joaomiguelvieira/Minotaur/pcb/minotaur_v2_0_BOM.csv

ID | Name | Designator | Footprint | Quantity | Manufacturer Part | Manufacturer | Supplier | Supplier Part | Price | Pins | JLCPCB Part Class | Contributor | Resistance (Ohms) | image
1 | 1234 | A1 | ARDUINO_NANO WITH MOUNTING HOLES | 1 | Arduino Nano |  |  |  |  | 30 |  | Der_Meister1979
2 | HNB09A05 | BUZZER | BUZ-TH_BD9.6-P5.00-D0.7-FD | 1 | HNB09A05 | HNDZ | LCSC | C96493 | 0.035 | 2
3 | 100nF | C1 | CAP-TH_L7.2-W2.5-P5.00-D0.5 | 1 | PE104J2A0501 | KYET(科雅) | LCSC | C390170 | 0.007 | 2 | Extended Part | LCSC
4 | 1nF | C2,C3 | CAP-TH_L7.2-W2.5-P5.00-D0.5 | 2 | PE102J2A0501 | KYET(科雅) | LCSC | C390167 | 0.008 | 2 | Extended Part | LCSC
5 | TC-1109-C-D | CLOSE,FUNC,OPEN,PROG,SELECT | KEY-TH_4P-L4.5-W4.5-P3.00-LS5.8 | 5 | TC-1109-C-D | XKB Enterprise | LCSC | C381026 | 0.005 | 4 |  | LCSC
6 | 39301240 | CN1 | CONN-TH_39301240 | 1 | 39301240 | MOLEX | LCSC | C492347 | 0.434 | 24 |  | LCSC
7 | 1N4148_C402212 | D1,D2,D3,D4,D5 | DO-35_BD2.0-L4.2-P8.20-D0.5-RD | 5 | 1N4148 | LGE | LCSC | C402212 | 0.001 | 2 |  | LCSC
8 | SS-12D02-VG4 | POWER | SW-TH_SS-12D02-VG4 | 1 | SS-12D02-VG4 | Rectangular Connectors - Contacts | LCSC | C136719 | 0.012 | 5 |  | LCSC
9 | BC547B | Q1,Q2,Q3,Q4,Q5 | TO-92-3_L4.9-W3.7-P1.27-L | 5 | BC547B | LGE | LCSC | C713613 | 0.004 | 3 | Extended Part | LCSC
10 | 51Ω | R1,R2,R3,R4,R5,R6,R7,R8,R9,R10 | RES-TH_BD2.3-L6.5-P10.50-D0.5 | 10 | CF1/4W-51Ω±5% T | CCO(千志电子) | LCSC | C120024 | 0.001 | 2 | Extended Part | LCSC | 51
11 | 100 | RB | RES-TH_BD2.5-L4.7-P8.70-D0.5 | 1 | CFS1/4CT26A101J | KOA Speer Elec | LCSC | C367443 | 0.036 | 2 |  | LCSC
12 | 1K | RC,RF,RO,RP | RES-TH_BD2.2-L6.5-P10.50-D0.9 | 4 | - | Chian Chia Elec | LCSC | C119870 | 0.001 | 2 |  | LCSC
13 | SRD-05VDC-SL-C | RLY1,RLY2,RLY3,RLY4,RLY5 | RELAY-TH_SRD-XXVDC-XL-C | 5 | SRD-05VDC-SL-C | SONGLE | LCSC | C35449 | 0.061 | 5 |  |  |  | //image.lceda.cn/szlcsc/C35449.jpg
14 | 1M | RS | RES-TH_BD2.3-L6.5-P10.50-D0.5 | 1 | - | Chian Chia Elec | LCSC | C120127 | 0.001 | 2 |  | LCSC
15 | 4N25 | U1,U2,U3,U4,U7 | DIP-6_L7.3-W6.5-P2.54-LS7.6-BL | 5 | 4N25 | EVERLIGHT | LCSC | C115480 | 0.025 | 6 |  | LCSC
16 | DB103-5.0-10P-GN-S | U5 | CONN-TH_10P-P5.00_DB103-5.0-10P-GN-S | 1 | DB103-5.0-10P-GN-S | DIBO | LCSC | C430588 | 0.115 | 10 |  | LCSC
17 | ACS712ELCTR-20A-T | U6,U8 | SOIC-8_L4.9-W3.9-P1.27-LS6.0-BL | 2 | ACS712ELCTR-20A-T | ALLEGRO(美国埃戈罗) | LCSC | C10681 | 0.354 | 8 | Extended Part
