joaomiguelvieira/Minotaur/doc/minotaur_v2_0_pcb_schematics.pdf

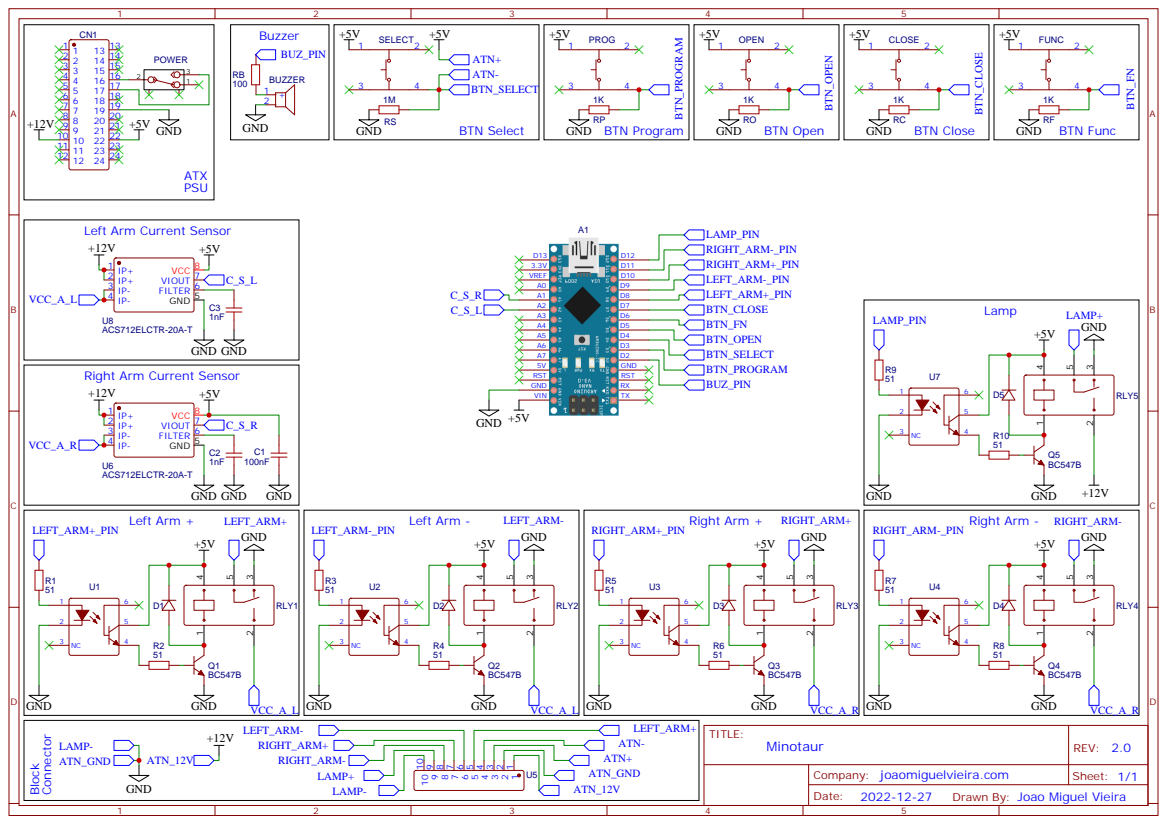
[picture p2: page 1]

Drawn By: Joao Miguel Vieira
