joaomiguelvieira/Minotaur/doc/minotaur_v1_1_pcb_schematics.pdf

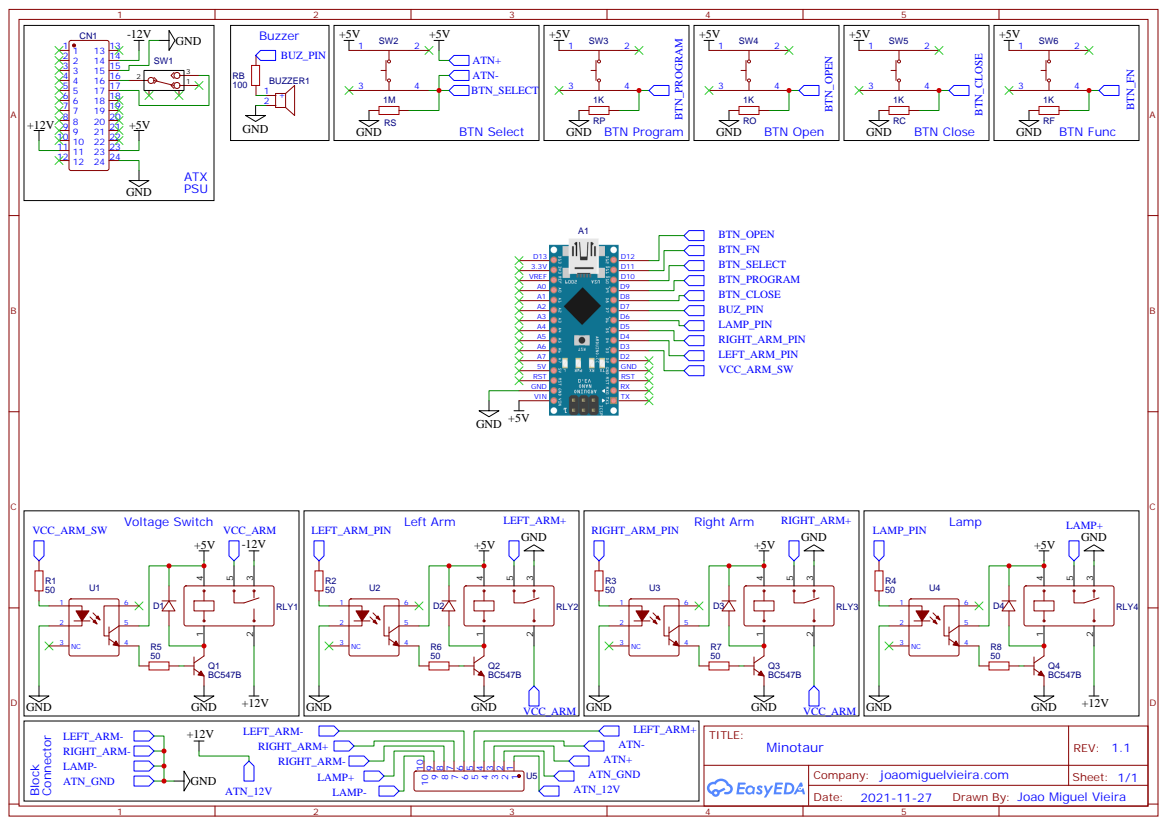
[picture p3: page 1]

Drawn By: Joao Miguel Vieira
