joaomiguelvieira/Minotaur/img/minotaur_v1_1_installation.png

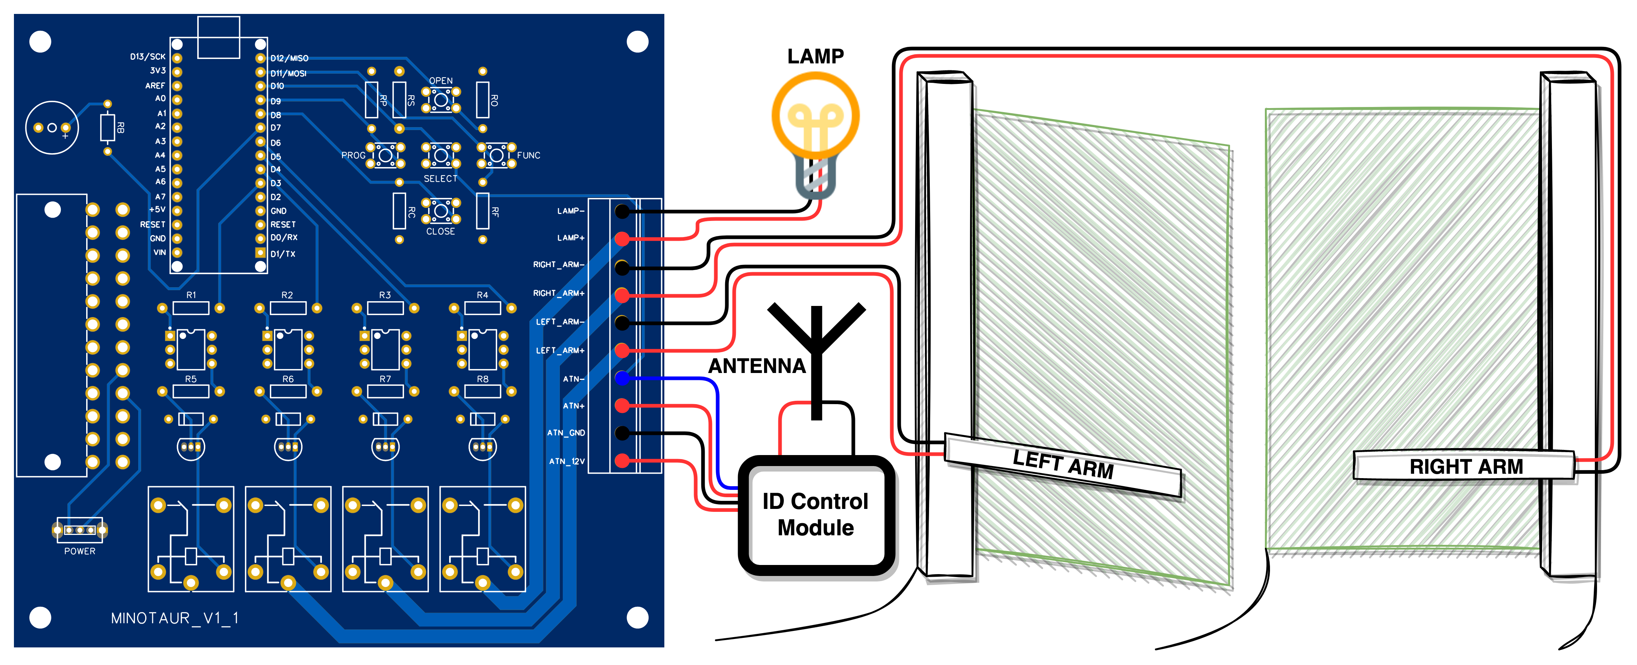
img/minotaur_v1_1_installation.png
