joaomiguelvieira/Minotaur/src/v2_0/minotaur/current_sensor.cpp

#include "current_sensor.h"

CurrentSensor::CurrentSensor(uint8_t pin) :
  pin(pin)
{}

uint16_t
CurrentSensor::getValue()
{
  return analogRead(pin);
}

void
CurrentSensor::setOffset()
{
  offset = analogRead(pin);
}

float
CurrentSensor::getAmps()
{
  return (1.0 * analogRead(pin) - offset) / 20;
}

uint16_t
CurrentSensor::getOffset()
{
  return offset;
}

float
CurrentSensor::value2Amps(uint16_t value)
{
  return (1.0 * value - offset) / 20; 
}
