joaomiguelvieira/Minotaur/(commit log)

2021-11-28 Finished Minotaur v1.1
    [minotaur_v1_1_BOM.csv]
2023-01-31 Updated repo to minotaur v2.0
    [minotaur_v2_0_BOM.csv]
